rgglez/cs-my-thesis-scip/software/README.md

# Source code

C and Assembly for 8080. Used Turbo C and Turbo Assembler.
