rgglez/cs-my-thesis-scip/document/caratula.tex

\begin{titlepage}

\special{center
         buap2.gif,                
         \the\hsize 45mm}

\vspace*{40mm}

\begin{center}

{\Large{\cal BENEM\'ERITA\\UNIVERSIDAD AUT\'ONOMA DE PUEBLA}}

\vspace*{5mm}

{\Large{\cal FACULTAD DE CIENCIAS DE LA COMPUTACI\'ON}}

\vspace*{8mm}

{\LARGE{\it SCIP}}

\vspace*{4mm}

{\LARGE Sistema de Coprocesamiento de Informaci\'on para PC}

\vspace*{10mm}

{\large{\it Tesis Profesional\\
que para obtener el t\'{\i}tulo de\\
Licenciado en Ciencias de la Computaci\'on\\
presenta}}
             
\vspace*{5mm}             
               
{\Large {\bf Rodolfo Gonz\'alez Gonz\'alez}}

\vspace*{8mm}

{\large Asesor

M.C. Rafael Rivera Rodr\'{\i}guez}

\vspace*{8mm}

{\large Puebla, Pue.\hspace*{8cm}1998.}

\end{center}
\end{titlepage}
