rgglez/cs-my-thesis-scip/document/dedica.tex

\begin{titlepage}

\vspace*{7cm}

\begin{center}

{\sl Dedico esta tesis a mis padres, Concepci\'on Gonz\'alez Mendoza y Rodolfo Gonz\'alez %%@
Garc\'{\i}a.}

\end{center}

\end{titlepage}
