rgglez/cs-my-thesis-scip/document/gracias.tex

\begin{titlepage}
\vspace*{3cm}
\begin{center}
{\sl 
A toda mi familia.
}
\end{center}
\end{titlepage}

\begin{titlepage}
\vspace*{1cm}
\end{titlepage}

\begin{titlepage}
\vspace*{3cm}
\begin{center}
{\sl
A mi asesor, M.C. Rafael Rivera Rodr\'{\i}guez, por su ayuda para la rea\-li\-za\-ci\'on de %%@
esta tesis.

\vspace*{1cm}

A los miembros de la Comisi\'on Revisora de la Academia de Hardware para asignaci\'on de %%@
menci\'on Cum Laude, y a los miembros del H. Jurado de Ex\'amen Profesional.

\vspace*{1cm}

Al M.C. Esteban Torres Le\'on y al Dr. Manuel Mart\'{\i}n Ort\'{\i}z, por la informaci\'on y %%@
sugerencias que ayudaron a llevar a cabo el proyecto.

\vspace*{1cm}

A mis profesores.

\vspace*{1cm}

A todo el personal del Laboratorio de Hardware de la F.C.C - B.U.A.P.
}
\end{center}
\end{titlepage}

\begin{titlepage}
\vspace*{1cm}
\end{titlepage}

\begin{titlepage}
\vspace*{3cm}
\begin{center}
{\sl 
A mis amigos y compa\~neros, especialmente a Vanessa Hekel Ensch, Berenice Bocanegra, Diana %%@
Ram\'{\i}rez, Iris Molleda, Margarita Barajas, Claudia Romero, Alberto Beltr\'an, Emilio Casco, %%@
Edmundo Mart\'{\i}nez, Abel Flores, Carlos A\-ya\-la Raggi, {\it et. al.}
}
\end{center}
\end{titlepage}
