rgglez/cs-my-thesis-scip/document/portada.tex

\begin{titlepage}
\begin{center}

{\Large{\it BENEM\'ERITA\\UNIVERSIDAD AUT\'ONOMA DE PUEBLA}}

\vspace*{5mm}

{\Large{\it FACULTAD DE CIENCIAS DE LA COMPUTACI\'ON}}

\vspace*{20mm}

{\LARGE{\it SCIP}}

\vspace*{5mm}

{\LARGE Sistema de Coprocesamiento de Informaci\'on para PC}

\vspace*{20mm}

{\large{\it Tesis Profesional\\
que para obtener el t\'{\i}tulo de\\
Licenciado en Ciencias de la Computaci\'on\\
presenta}}
             
\vspace*{5mm}             
             
{\Large {\bf Rodolfo Gonz\'alez Gonz\'alez}}

\vspace*{20mm}

{\large Asesor

M.C. Rafael Rivera Rodr\'{\i}guez}

\vspace*{20mm}

{\large Puebla, Pue.\hspace*{8cm}1998.}

\end{center}
\end{titlepage}
