rgglez/cs-my-thesis-scip/document/diagrama.TEX

\chapter[Diagramas.]{Diagramas.}
\label{Apendice:diagramas}

%----------------------------------------------------------------------------

\fancyhead[RE]{\slshape SCIP - Ap. \thechapter~ - Diagramas.}
\fancyhead[LO]{\slshape Rodolfo Gonz\'alez Gonz\'alez.}
\fancyhead[LE,RO]{\thepage}

%----------------------------------------------------------------------------

En este ap\'endice se presentan los diagramas por m\'odulos del sistema, as\'{\i} como el %%@
diagrama general.

Los diagramas fueron creados con OrCAD y est\'an organizados como se describe a continuaci\'on:

\begin{description}
\item[Hoja 1] - M\'odulo de Procesamiento.
\item[Hoja 2] - M\'odulo de Decodificaci\'on de la Tarjeta.
\item[Hoja 3] - M\'odulo de Comunicaci\'on.
\item[Hoja 4] - M\'odulo de Generaci\'on de L\'{\i}neas de Control/IRQ's.
\item[Hoja 5] - M\'odulo de Decodificaci\'on Interna.
\item[Hoja 6] - M\'odulo de Memoria.
\end{description}

El diagrama general se presenta al final del ap\'endice.

%----------------------------------------------------------------------------

\cleardoublepage

%----------------------------------------------------------------------------
