rgglez/cs-my-thesis-scip/document/tesis.tex

%----------------------------------------------------------------------------
% Autor: Rodolfo González González.
% T¡tulo: Documento principal de la Tesis para Licenciatura.
% (Cum Laudae)
% Fecha de inicio: 31-XII-1996.
%----------------------------------------------------------------------------

\documentclass[12pt,twoside]{emtex/rgg-rep}
\usepackage{fancyhdr}
\usepackage{moreverb}
\usepackage{gensymb}

%----------------------------------------------------------------------------

\hyphenation{de-co-di-fi-ca com-pu-ta-do-ra re-gis-tros ins-truc-cio-nes mi-cro-pro-ce-sa-do-%%@
res mi-cro-pro-ce-sa-dor a-rit-me-ti-cas ins-truc-cio-nes dis-po-si-ti-vo si-mul-ta-nea-men-te %%@
in-te-rrup-ci-on mul-ti-plexa-do re-pre-sen-tar mo-ni-to-ree de-co-di-fi-ca-dor ha-bi-li-ta en-%%@
ton-ces con-fi-gu-ra-ci-on re-pre-sen-ta ha-bi-li-ta-das es-pe-ra trans-fe-ren-cia mo-di-fi-ca-%%@
da ge-ne-ra-dor im-por-tan-tes de-sa-rro-lla-do pe-rio-do e-qui-va-len-tes com-pa-ti-ble es-tas %%@
co-rrien-te bi-direccio-nal} 

%----------------------------------------------------------------------------

\begin{document}

%----------------------------------------------------------------------------

\input{caratula}
\begin{titlepage} 
\vspace*{1cm}
\end{titlepage}

%----------------------------------------------------------------------------

\input{portada}
\begin{titlepage} 
\vspace*{1cm}
\end{titlepage}

%----------------------------------------------------------------------------

\input{dedica}
\begin{titlepage} 
\vspace*{1cm}
\end{titlepage}
\addtocounter{page}{-1}

%----------------------------------------------------------------------------

\input{gracias}
\begin{titlepage} 
\vspace*{1cm}
\end{titlepage}
\addtocounter{page}{-1}

%----------------------------------------------------------------------------

\begin{titlepage}
\vspace*{7cm}
\begin{center}
{\large Ah!, On, Off, simplement!...}
\end{center}
\begin{flushright}
{\large Jean-Michel Jarre.}
\end{flushright}
\end{titlepage}
\begin{titlepage} 
\vspace*{1cm}
\end{titlepage}
\addtocounter{page}{-1}

%----------------------------------------------------------------------------

\cleardoublepage
\tableofcontents

%----------------------------------------------------------------------------

\cleardoublepage
\listoffigures

%----------------------------------------------------------------------------

\cleardoublepage
\listoftables

%----------------------------------------------------------------------------

\pagestyle{plain}

%----------------------------------------------------------------------------

\cleardoublepage
\addcontentsline{toc}{chapter}{Introducci\'on y Objetivos.}
\input{introbj}

%----------------------------------------------------------------------------

\pagestyle{fancy}
\fancyhead{}
\fancyfoot{}

\cleardoublepage
\input{cap1}

%----------------------------------------------------------------------------

\cleardoublepage
\input{cap2}

%----------------------------------------------------------------------------

\cleardoublepage
\input{cap3}

%----------------------------------------------------------------------------

\cleardoublepage
\input{cap4}

%----------------------------------------------------------------------------

\cleardoublepage
\pagestyle{plain}
\addcontentsline{toc}{chapter}{Conclusiones y Perspectivas.}
\input{conclu}

%----------------------------------------------------------------------------

\cleardoublepage
\addcontentsline{toc}{chapter}{Bibliograf\'{\i}a.}
\input{biblio}

%----------------------------------------------------------------------------

\appendix

\pagestyle{fancy}
\fancyhead{}
\fancyfoot{}

%----------------------------------------------------------------------------

\cleardoublepage
\input{manual}

%----------------------------------------------------------------------------

\cleardoublepage 
\input{chips}

%----------------------------------------------------------------------------

\cleardoublepage 
\input{diagrama}

%----------------------------------------------------------------------------

\end{document}

%----------------------------------------------------------------------------
