rgglez/cs-my-thesis-scip/document/1-1.gif

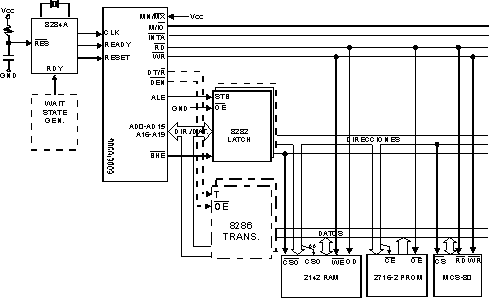
document/1-1.gif
