rgglez/cs-my-thesis-scip/document/1-2.gif

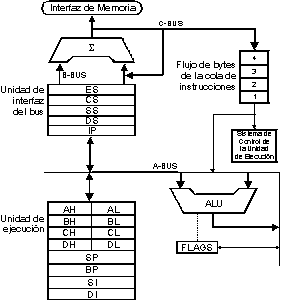
document/1-2.gif
