rgglez/cs-my-thesis-scip/document/1-3.gif

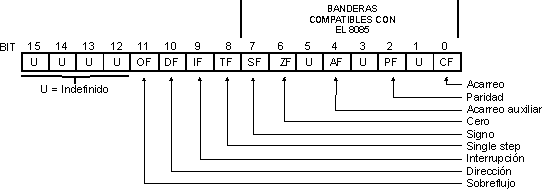
document/1-3.gif
