rgglez/cs-my-thesis-scip/document/1-6.gif

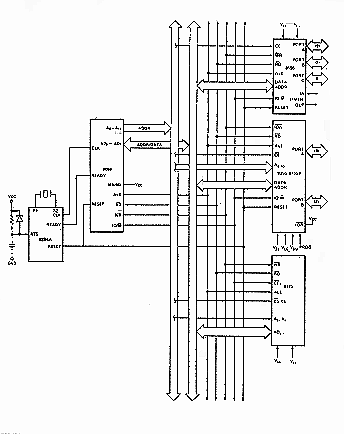
document/1-6.gif
