rgglez/cs-my-thesis-scip/document/1-7.gif

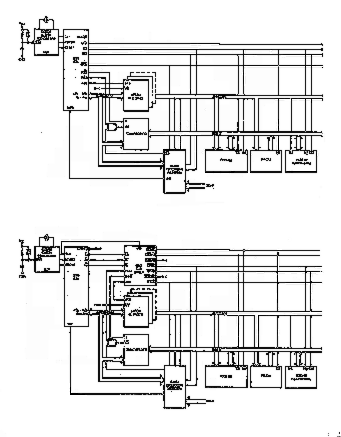
document/1-7.gif
