rgglez/cs-my-thesis-scip/document/2-1.gif

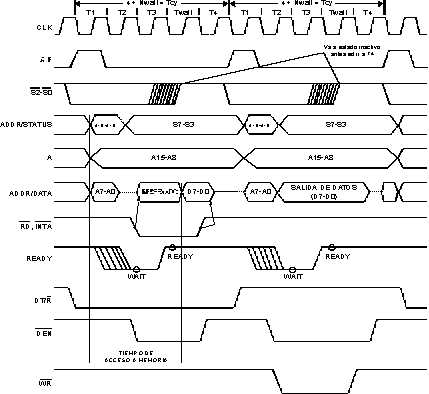
document/2-1.gif
