rgglez/cs-my-thesis-scip/document/88-87.gif

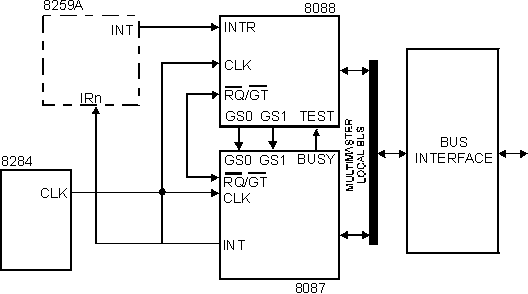
document/88-87.gif
