rgglez/cs-my-thesis-scip/document/8087.gif

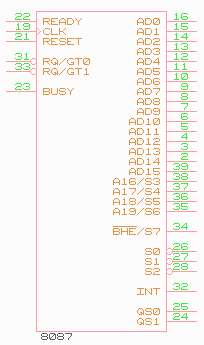
document/8087.gif
