rgglez/cs-my-thesis-scip/document/8087/FLUJO1.GIF

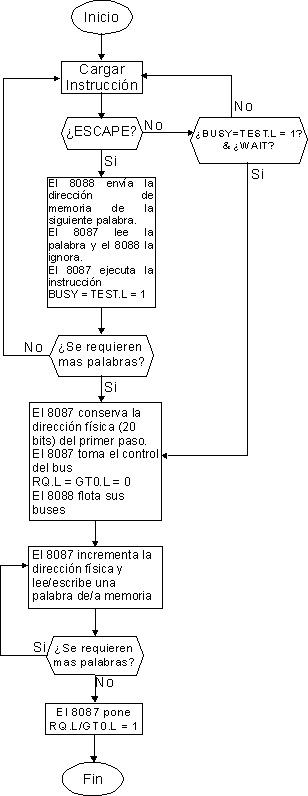
document/8087/FLUJO1.GIF
