rgglez/cs-my-thesis-scip/document/8087a.gif

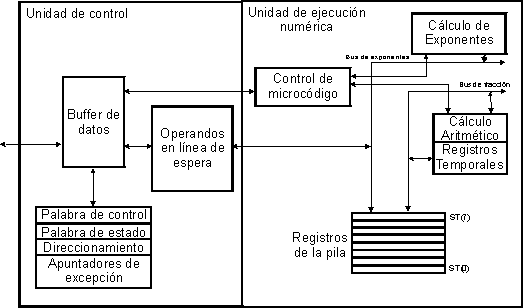
document/8087a.gif
