rgglez/cs-my-thesis-scip/document/8088max.gif

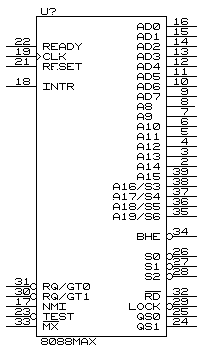
document/8088max.gif
