rgglez/cs-my-thesis-scip/document/8088min.gif

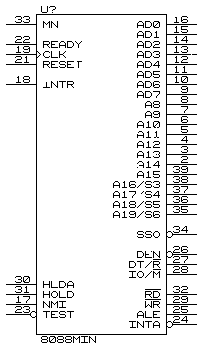
document/8088min.gif
