rgglez/cs-my-thesis-scip/document/8237.gif

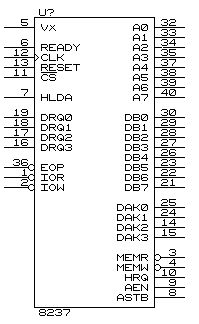
document/8237.gif
