rgglez/cs-my-thesis-scip/document/8255.gif

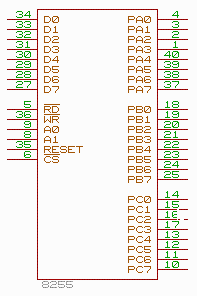
document/8255.gif
