rgglez/cs-my-thesis-scip/document/8259a.gif

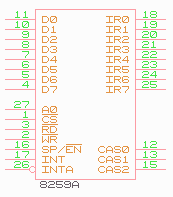
document/8259a.gif
