rgglez/cs-my-thesis-scip/document/8284.gif

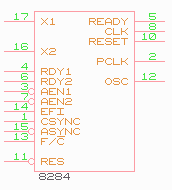
document/8284.gif
