rgglez/cs-my-thesis-scip/document/8288.gif

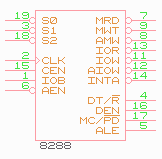
document/8288.gif
