rgglez/cs-my-thesis-scip/document/27512.gif

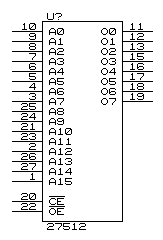
document/27512.gif
