rgglez/cs-my-thesis-scip/document/bloque1.gif

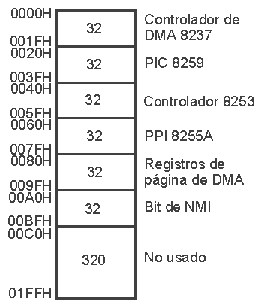
document/bloque1.gif
