rgglez/cs-my-thesis-scip/document/bloque2.gif

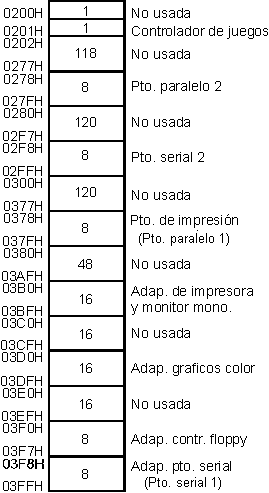
document/bloque2.gif
