rgglez/cs-my-thesis-scip/document/bloques.GIF

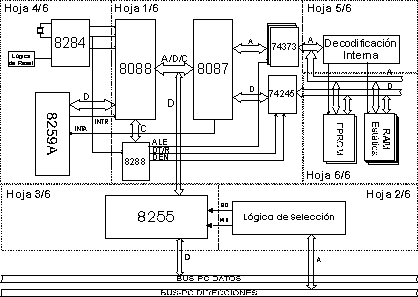
document/bloques.GIF
