rgglez/cs-my-thesis-scip/document/Buap2.gif

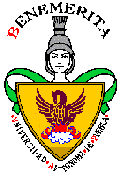
document/Buap2.gif
