rgglez/cs-my-thesis-scip/document/dmablock.gif

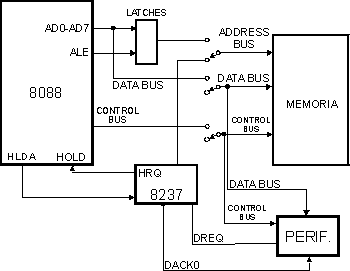
document/dmablock.gif
