rgglez/cs-my-thesis-scip/document/flujo1.gif

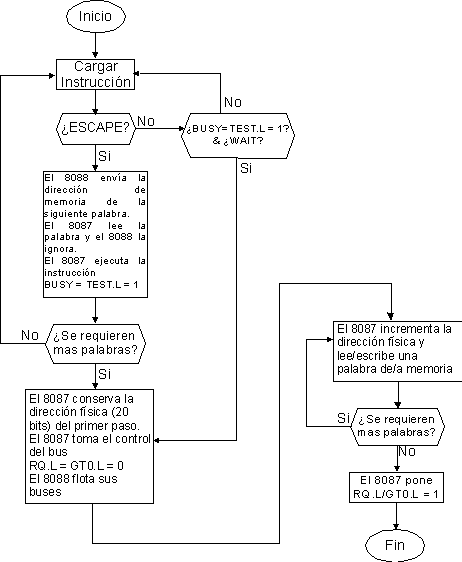
document/flujo1.gif
