rgglez/cs-my-thesis-scip/document/foto1.gif

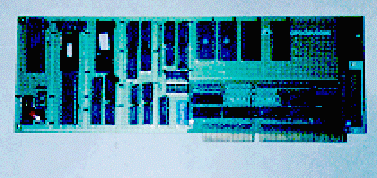
document/foto1.gif
