rgglez/cs-my-thesis-scip/document/foto2.gif

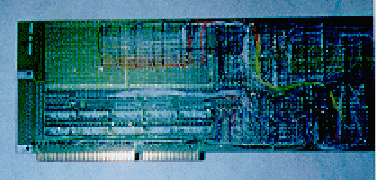
document/foto2.gif
