rgglez/cs-my-thesis-scip/document/intacksq.gif

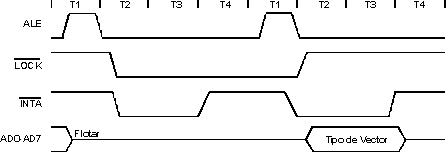
document/intacksq.gif
