rgglez/cs-my-thesis-scip/document/mapamem.gif

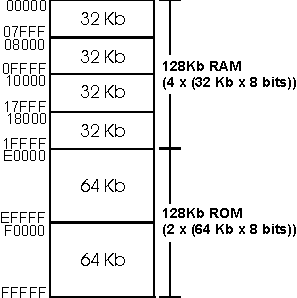
document/mapamem.gif
