rgglez/cs-my-thesis-scip/document/ptosio.gif

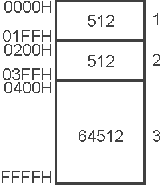
document/ptosio.gif
