rgglez/cs-my-thesis-scip/exam/buap.gif

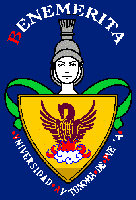
exam/buap.gif
