rgglez/cs-my-thesis-scip/exam/parte1.gif

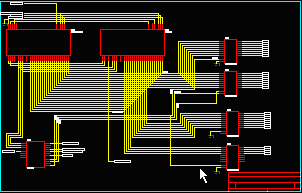
exam/parte1.gif
