rgglez/cs-my-thesis-scip/exam/parte2.gif

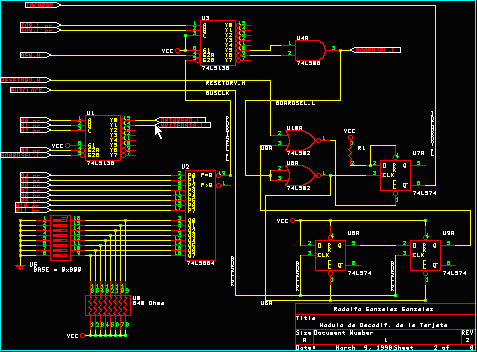
exam/parte2.gif
