rgglez/cs-my-thesis-scip/exam/parte3.gif

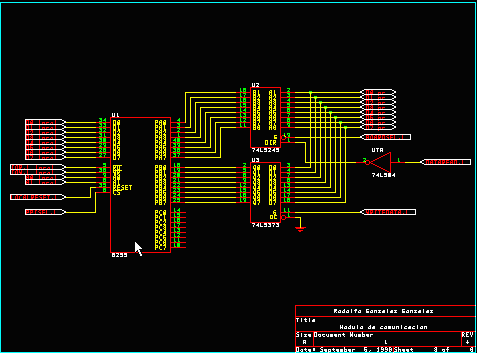
exam/parte3.gif
