rgglez/cs-my-thesis-scip/exam/parte4.gif

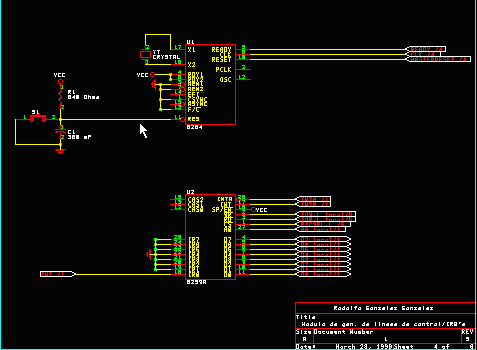
exam/parte4.gif
