rgglez/cs-my-thesis-scip/exam/parte5.gif

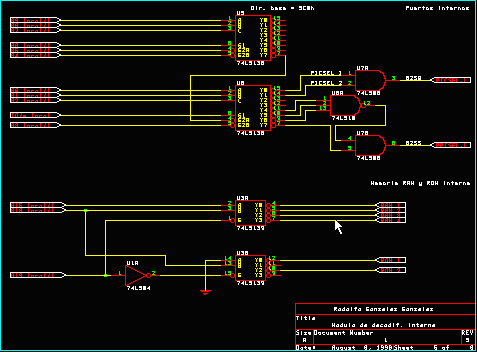
exam/parte5.gif
