rgglez/cs-my-thesis-scip/exam/parte6.gif

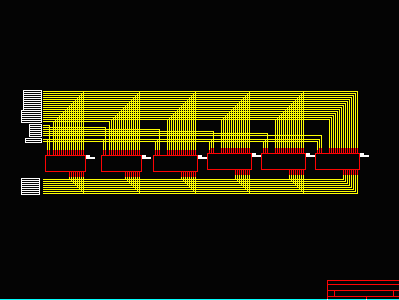
exam/parte6.gif
