rgglez/cs-my-thesis-scip/exam/total.gif

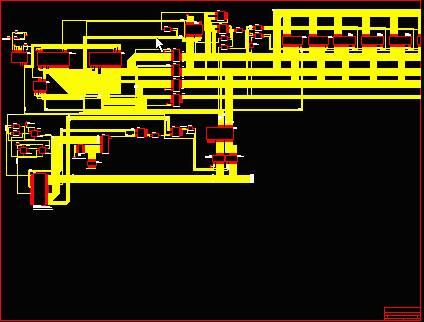
exam/total.gif
