rgglez/cs-my-thesis-scip/document/montaje.gif

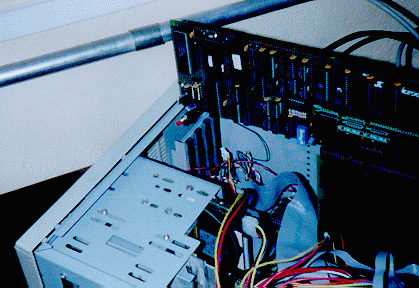
document/montaje.gif
