rgglez/cs-my-thesis-scip/(notices)

Notices in the files:
README.md:
CC BY-NC-ND 4.0
